camelNote/CameraPowerAdapter/CurrentSetup.JPG

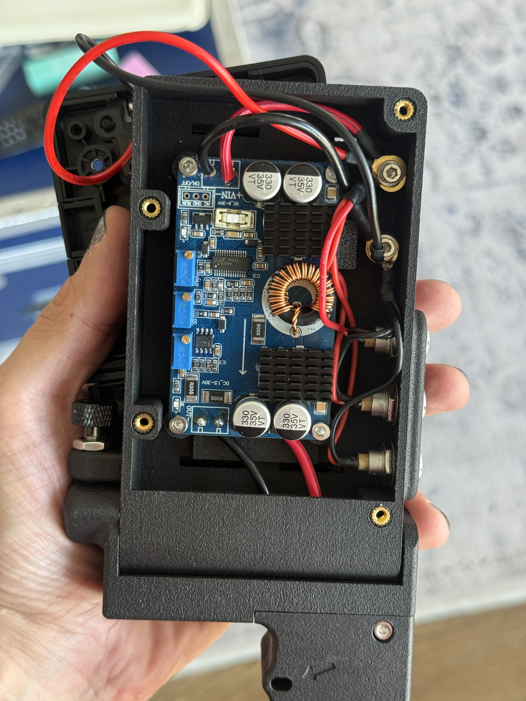
CurrentSetup.JPG
