camelNote/CameraPowerAdapter/DesignDocs/CameraPowerAdapter_DesignDocument.pdf

### Vintage Film Camera Equipment

# Dual-Input Priority-Switched

# Buck-Boost Power Adapter

## Custom Datasheet & Design Calculations

Document ID | CPA-DD-001
Revision | 0.1 — Draft / Template
Date | October 5, 2026
Author | [TODO: name]
Status | Work in progress — sections marked [TODO: ] are incomplete
Related spec | Specifications/SpecSheet.pdf
Supporting docs | BuckBoostTopology.md, ComponentSelection.md, SchematicBOM.md

This document defines the board as a standalone power module (custom datasheet) and records the calculations behind every selected value (design calculations).

Camera Power Adapter | Custom Datasheet & Design Calculations

### Contents

1 Introduction | 2
2 System Overview | 3
3 Custom Datasheet | 3
4 Design Calculations | 5
5 Verification & Test Plan | 8
6 Open Items & Risks | 9
A Bill of Materials | 9
B Equation Reference | 9
C Design Decisions Log | 9
D Open Items & Risk Register | 10
E Revision History | 10
F References | 10

### 1 Introduction

### 1.1 Purpose

This document serves two functions:
1. A custom datasheet for the assembled adapter — what the board does, its limits, and how to connect it.
2. A design calculation record — every value on the schematic is derived from an equation traceable to a manufacturer datasheet.

### 1.2 Scope

The adapter accepts two independent 11 V to 36 V DC inputs with fixed priority (Input 2 preferred), protects against reverse polarity and overcurrent, and delivers a jumper-selected 12 V or 24 V output rated 6 A to 8 A (burst duty cycle; see subsection 3.3).
[TODO: Confirm scope wording against the final schematic.]

### 1.3 Related documents

Document | Contents
Specifications/SpecSheet.pdf | Customer requirements / acceptance criteria
BuckBoostTopology.md | LT8390 stage build guide and audit log
ComponentSelection.md | Value-by-value selection rationale
SchematicBOM.md | Current bill of materials and placement status
Datasheets/ | Manufacturer datasheets (local copies)

Table 1: Reference documents.

### 1.4 Acronyms

Term | Meaning
UVLO | Under-voltage lockout
CC | Constant-current (limit)
HS / LS | High-side / low-side MOSFET switch
PGOOD Power-good output of the LT8390 (active low) NTC Negative temperature coefficient thermistor

Table 2: Acronyms and definitions.

### 2 System Overview

### 2.1 Block diagram

Figure placeholder

Input 1 → [fuse, reverse-pol.] Input 2 → [fuse, reverse-pol.] }︃
Priority mux (LTC4417) → LT8390 buck-boost

→ 12 V/24 V output
Export a block diagram from KiCad or draw with TikZ and \includegraphics here.

Figure 1: System block diagram. [TODO: replace placeholder.]

### 2.2 Operating modes

Mode | Behaviour
Input priority | Input 2 powers the board whenever it is valid; automatic fallback to Input 1.
Buck region | VIN > VOUT — buck leg switches.
Boost region | VIN < VOUT — boost leg switches.
Overlap band | VIN ≈ VOUT — both legs switch (worst thermal corner).
Output select | Jumper fitted = 12 V; jumper removed = 24 V.
Over-temp fault Latch pulls EN/UVLO low until input power is cycled.

Table 3: Operating modes.

### 3 Custom Datasheet

### 3.1 Description

Dual-input, priority-selected, non-isolated synchronous buck-boost DC/DC adapter for vintage film camera equipment. Intended for low-duty-cycle loads (short bursts) inside a small enclosure — the enclosure floor acts as the heat sink through a bottom-side thermal pad.

### 3.2 Absolute maximum ratings

Parameter | Conditions / note | Max
Input voltage, either input | Continuous; reverse-polarity block extends to
| −42 V | 36 V
Output current | Burst rating | 8 A
Output current | Continuous duty (thermal-limited) | [TODO: 2 A?]
Operating ambient temperature [TODO: state enclosure assumption] | [TODO: ]
Storage temperature | | [TODO: ]

Table 4: Absolute maximum ratings. Stresses beyond these may damage the board.

### 3.3 Recommended operating conditions

Parameter | Conditions / note | Value
Input 1 voltage Valid operating window (UVLO ≈ 11 V) | 11 V to 36 V
Input 2 voltage Valid operating window (UVLO ≈ 11 V) | 11 V to 36 V
Output voltage | Jumper selection | 12 V or 24 V
Output current Real duty cycle (per spec) | 2 A to 4 A typical
Output current Short-burst rating | 6 A to 8 A
Ambient | Inside camera enclosure | [TODO: ]

Table 5: Recommended operating conditions.

### 3.4 Electrical characteristics

[TODO: fill min/typ/max columns once the first board is measured; values below are design targets, not tested limits.]

Parameter | Conditions / note | Target

Inputs
Input priority | Fixed, not voltage-based | Input 2 > Input 1
UVLO per channel | Set by priority controller; below mux floor | 11 V ± [TODO: ]
Reverse polarity | Both inputs independently | −42 V capable
Fuse per input line | Sized from worst-case input current | [TODO: rating]
Input current (worst case) POUT /(η · VIN,min) | [TODO: value in A]

Output
Output voltage accuracy | LT8390 FB accuracy | ±1.5 %
Output current limit | R11 = 12 m Ω (provisional) | 8.33 A
Output ripple | Measured at rated burst load | [TODO: mVpp]

Protection & indicators
Over-temperature trip | NTC/TL431 latch (provisional) | ≈85 ◦C ± 8

◦C
Fault recovery | Latch-off; requires input power cycle | —
Indicators | Green = output OK, red = fault, red = over-
temp

see Table 9

Table 6: Electrical characteristics (design targets).

### 3.5 Connector pinout

Designator | Signal | Note
IN1 | Input 1 positive | M3 solder-on threaded standoff
IN1 | Input 1 return | M3 solder-on threaded standoff
IN2 | Input 2 positive | M3 solder-on threaded standoff
IN2 | Input 2 return | M3 solder-on threaded standoff
OUT | Output positive (V+) | M3 solder-on threaded standoff
OUT | Output return (GND) M3 solder-on threaded standoff

Table 7: I/O connections. [TODO: confirm silkscreen labels once the layout is done.]

### 3.6 Mechanical & environmental

Parameter | Value / requirement
PCB outline | 45 mm × 75 mm max
Mounting holes | 4 × 3 mm dia., 70 mm × 40 mm pattern
Bottom thermal pad 45 mm × 40 mm, contact with enclosure floor
Assembled height | < 13.5 mm target; 18 mm fallback ceiling
Indicators | Bottom side, output end

Table 8: Mechanical requirements.

### 3.7 Indicator logic

Green (power) Red (fault) Red (over-temp)

ON | OFF | OFF
OFF | ON | OFF
OFF | OFF | ON

Table 9: Indicator truth table. [TODO: add state column once LED wiring is final.]

### 3.8 Typical application

Place the annotated top-level schematic or KiCad plot here.

Figure 2: Typical application circuit. [TODO: replace placeholder.]

### 4 Design Calculations

Note — All equations are from the LT8390 datasheet, Rev. F (Applications Informa-tion, pp. 17–25) unless stated otherwise. Values tagged (provisional) are carried over from BuckBoostTopology.md and must be re-verified once the schematic is frozen.

### 4.1 Input stage — priority mux and protection

- Priority controller: LTC4417 (or equivalent) — fixed pin-assigned priority, Input 2 wired to the highest-priority pin.
- Per-channel UVLO: program the controller’s undervoltage threshold to 11 V. [TODO: insert resistor calculation from the LTC4417 datasheet: VUV threshold and hysteresis formulas, show Rtop, Rbot.]
- Fuse sizing (each input line, ahead of the mux):

IF USE ≥

POUT

η · VIN,min

kmargin | (1)

with the worst-case input current evaluated at VIN,min = 11 V and the burst power (24 V × 8 A = 192W). Margin factor kmargin = [TODO: 1.5–2, to be confirmed]. [TODO: finalize after the efficiency estimate (subsection 4.9)].

### 4.2 Buck-boost power stage

### 4.2.1 Switching frequency

R12 = 226 kΩ (1 %) selects fSW = 200 kHz (datasheet Table 1). Spread spectrum ON (±15 % modulation) for lower EMI. Rationale: thermal/size compromise; see Appendix C.

### 4.2.2 Inductor ripple current

∆IL(BUCK) =

VOUT (VIN(MAX) − VOUT )

fSW L VIN(MAX)

(2)

∆IL(BOOST) =

VIN(MIN)

(VOUT − VIN(MIN)

)

fSW L VOUT

(3)

Worked worst case (11 V in, 24 V out, L = 10 µH, fSW = 200 kHz):

∆IL(BOOST) =

11 V (24 V − 11 V)
200 kHz · 10 µH · 24 V
≈ 2.98 A | (4)

### 4.2.3 Inductor selection

LBUCK >

VOUT (VIN(MAX) − VOUT )

fSW IOUT ∆IL% VIN(MAX)

(5)

LBOOST >

V

2
IN(MIN)

(VOUT − VIN(MIN)

)

fSW IOUT ∆IL% V

2
OUT

(6)

slope-comp. stability: L > 10 VOUT RSENSE

fSW

≈ 2.4 µH | (7)

Chosen: L1 = 10 µH, ≥18 A saturation, ferrite, low DCR. Height-budget tradeoff: the 11 V→24 V, 8 A corner peaks at ≈19 A — accepted, see risk log (Appendix D).

### 4.2.4 Inductor current sense and peak limit

RSENSE(BUCK) =

2 · 50 mV

2 IOUT + ∆IL(BUCK)

(8)

RSENSE(BOOST) =

2 · 50 mV · VIN(MIN)

2 IOUT VOUT + ∆IL(BOOST) VIN(MIN)

(9)

Worst corner (11 V in, 24 V out, 8 A): RSENSE(BOOST) ≈ 2.64 m Ω. Chosen R5 = 2 m Ω ⇒ 24 % margin (datasheet requires final value 20–30 % below calculated). Peak limit: IP EAK = 50 mV/R5 = 25 A.

### 4.2.5 Output CC limit and monitor

With CTRL tied to VREF (≥ 1.35 V), the ISP/ISN threshold is the full 100 mV scale:

ILIM =

100 mV

R11

=

100 mV
12 m Ω = 8.33 A | (10)

Monitor output: VISMON = 10 V(ISP −ISN)+0.25 V. [TODO: transcription re-checked against the LT8390 datasheet p. 22.]

### 4.2.6 Capacitors

- Input: RMS ripple current in the buck region IIN,RMS ≈ IOUT √︁
D(1 − D), D = VOUT /VIN ;
worst case D = 0.5 gives IOUT /2 ≈ 4 A at the 8 A burst rating — shared by C11–C14 (4 × 10 µF, 50 V X7R/X7S, 1210). Plus C8 = 1 µF at the VIN pin.
- Output: C19–C22 (4 × 10 µF, 50 V) + C23 (180 µF polymer); C24 = 1 µF at the VOUT pin.
- Bootstrap: C10, C18 = 100 nF X7R (≥100× top-FET gate charge; datasheet range 0.1 µF to 0.47 µF).
- INTVCC: C15 = 4.7 µF plus a second 1 µF right at the pin (datasheet layout recommenda-tion).

### 4.2.7 MOSFET selection

Q3–Q6 = NCEP40T11G (logic-level; gate drive is the 5 V INTVCC rail). RDS(ON) ≈ 3.3 m Ω typ. at VGS = 4.5 V. 40 V BVDSS on a 36 V rail leaves ≈11 % ringing headroom — bench-verify, snubber if needed.

### 4.3 Feedback divider and output voltage select

VOUT = 1.00 V ×

Rtop + Rbot

Rbot

, | Rbot = R17 = 10.0 kΩ | (11)
12 V : Rtop = R15 = 110 kΩ | (12)
24 V : Rtop = R15 + R16 = 230 kΩ | (13)

J1 shunts R16: fitted = 12 V, removed = 24 V; a missing jumper defaults to 12 V (fails low, no runaway).

### 4.4 Enable / UVLO

VIN(turn-on) = 1.233 V ·

R8 + R9
R9

+ 2.5 µA · R8

VIN(turn-of f) = 1.220 V ·

R8 + R9
R9

(14)

With R8 = 365 kΩ, R9 = 56.2 kΩ: ≈10.2 V on, ≈9.1 V off — deliberately below the LTC4417’s 11 V floor so the mux arbitrates first.

### 4.5 Soft-start and compensation

tSS =

1 V · C9
12.5 µA

=

1 V · 100 nF
12.5 µA
≈ 8 ms | (15)

R10 = 499 kΩ (SS→VREF) selects latch-off on fault. Compensation R13 = 15 kΩ + C25 = 15 nF; bench-tune with load steps at both outputs. Constraint: C9 ≥ 5–10 × C25 (ratio here: 6.7×, OK).

### 4.6 Over-temperature latch

Trip point set by the NTC divider against the TL431’s 2.495 V reference, fed from a 5.1 V zener rail so the trip point barely moves with battery voltage:

RNT C(trip) = R21 (︃

VZ
2.495

− 1

)︃
= 1.33k

(︃

5.1
2.495

− 1

)︃
≈ 1.39 kΩ | (16)

⇒ trip ≈85 ◦C nominal, ±8

◦C realistic (zener tolerance, TL431 grade, NTC B-tolerance). TH1 (10 k NTC) must be mounted on the hot copper, not in free air. Latch resets only when input power is cycled.

### 4.7 Indicator resistors

Continuous worst case is 36 V input; sizes chosen so no resistor exceeds ≈50 % of its package rating:

Ref | Value | Dissipation (worst case) Package
R18 (green) 4.7 kΩ | ≈0.10W | 1206
R19 (red) | 6.8 kΩ | ≈0.17W | 1206 min., 2010 preferred
R29 (red) | 6.8 kΩ | ≈0.17W | 1206 min., 2010 preferred

Table 10: LED series resistors. [TODO: re-check currents against final LED VF bins.]

### 4.8 Thermal analysis

- INTVCC self-heating (≈1.6W inside the IC at 36 V, 200 kHz, four ≈50 nC gates):
P = VIN · IINT V CC ≈ 36 · 45 mA ≈ 1.6W, | TJ = TA + P θJA | (17)

[TODO: verify θJA for the chosen layout and confirm TJ at max ambient; fallback options: 150 kHz, lower-Qg FETs.]
- Bottom thermal pad: 45 mm×40 mm exposed pad, vias from U1 exposed pad and the power MOSFETs; contact with the enclosure floor. [TODO: add measured case temperature once available.]
- Heatsinks: low-profile finned heatsinks on U1 and the switching MOSFETs where height allows.

### 4.9 Efficiency budget

[TODO: fill from bench measurement or a loss budget (conduction + switching + gate charge). One row per corner:]

Corner | Input | Output
Buck, 36 V → 12 V, 2 A | [TODO: %] [TODO: %]
Buck-boost corner, 12 V in, 12 V out [TODO: %] [TODO: %]
Boost, 11 V → 24 V, 2 A | [TODO: %] [TODO: %]

Table 11: Efficiency at nominal duty.

### 5 Verification & Test Plan

[TODO: expand into a full procedure once the first board is built.]

Test | Pass criterion
Input priority | Input 2 always selected when valid; clean fallback to Input 1
UVLO per channel Both channels disable below 11 V, restart above it
Reverse polarity | No damage / no output with either input reversed
Output voltage | 12 V and 24 V within ±1.5 % at nominal load
Output CC limit | Current limit at 8.33 A ± tolerance
Load transient | Stable at both outputs, no latch-off, acceptable deviation
Over-temp trip | Latch fires at target temperature; recovers only on power cycle
Thermal soak | TJ , case and enclosure-floor temperatures within limits at worst corner

Table 12: Verification test matrix.

### 6 Open Items & Risks

See the risk register in Appendix D.

### A Bill of Materials

[TODO: Keep in sync with SchematicBOM.md; summarize the main parts here.]

Ref | Part / value | Purpose | Status
U1 | LT8390 (TSSOP-28 EP) Buck-boost controller | placed
Q3–Q6 | NCEP40T11G | Power switches | placed
L1 | 10 µH, ≥18 A sat | Main inductor | placed
R5 | 2 m Ω | Inductor current sense | placed
R11 | 12 m Ω | Output current sense | placed
U3 + TH1 | TL431 + NTC | Over-temp comparator / sen-
| | sor | [TODO: verify]
Q7–Q11, D1–D4, J1 | [TODO: parts] | Latch, LEDs, output select | to add

Table 13: Principal components (excerpt).

### B Equation Reference

Full derivations live in section 4; this is a quick-reference index.

Quantity | Equation | | Source
Inductor ripple (buck) | VOUT (VIN(MAX) − VOUT )/(fLVIN(MAX)
| | ) | LT8390 p. 18
Inductor ripple (boost) VIN(MIN)

(VOUT − VIN(MIN)

| | )/(fLVOUT ) | LT8390 p. 18
Peak current limit | IP EAK = 50 mV/RSENSE | LT8390 p. 18
Output CC limit | ILIM = 100 mV/R11 (CTRL high) | LT8390 p. 22
Output voltage | VOUT = 1.00 · (Rtop + Rbot)/Rbot | LT8390 p. 21
UVLO | VIN = 1.233 (R8 + R9)/R9 + 2.5 µA R8 | LT8390 p. 21
Soft-start | tSS = 1 V · C9/12.5 µA | LT8390 p. 21
NTC trip resistance | RNT C = R21(VZ/2.495 − 1) | TL431 datasheet
NCV/[TODO:] | [TODO: ] | | [TODO: ]

Table 14: Equation quick reference.

### C Design Decisions Log

Decision | Date
LT8390 4-switch buck-boost: single inductor, input straddles both outputs, PGOOD + latch-off available. | 2026-09
200 kHz switching: thermal/size compromise; spread spectrum on. | 2026-09
10 µH/18 A-sat inductor: height budget; accepted 19 A corner peak. | 2026-09
Jumper presets instead of trim pot: no drift, no knob to bump, lower height. | 2026-09
Latch pulls EN/UVLO: assured full shutdown; resets only on power cycle. | 2026-09
Two red LEDs (fault vs. over-temp): distinguishable states, simpler than steered diode. | 2026-09
[TODO: append each new decision with rationale and date.]

Table 15: Design decision record.

### D Open Items & Risk Register

Item | Severity | Status
Analog support blocks (Q7–Q11, D1–D4, J1, TH1) not yet placed | high | open
No footprints assigned on any symbol | high | open
Fuse ratings not finalized | medium | open
INTVCC self-heating (≈1.6W) — TJ margin unverified | high | open
19 A corner peak vs. 18 A inductor saturation | medium | accepted
40 V FETs on 36 V rail — ringing headroom | medium | bench-check
Height budget: PCB + parts + heatsink under 13.5 mm | medium | open

Table 16: Open items carried from the current schematic audit.

### E Revision History

Rev | Date | Author | Change
0.1 | October 5, 2026 [TODO: name] Initial template created
[TODO: ] [TODO: ] | [TODO: ] | [TODO: ]

Table 17: Revision history.

### F References

[1] LT8390 datasheet, Rev. F — Datasheets/LTC8390.pdf
[2] LTC4417 datasheet — Datasheets/LTC4417.pdf
[3] NCEP40T11G datasheet — Datasheets/NCEP40T11G.pdf
[4] TL431 datasheet — [TODO: download to Datasheets/agentDownload/]
[5] Project specification — Specifications/SpecSheet.pdf
[6] [TODO: add any further references as they are used.]
