camelNote/CameraPowerAdapter/PageScreenshot.png

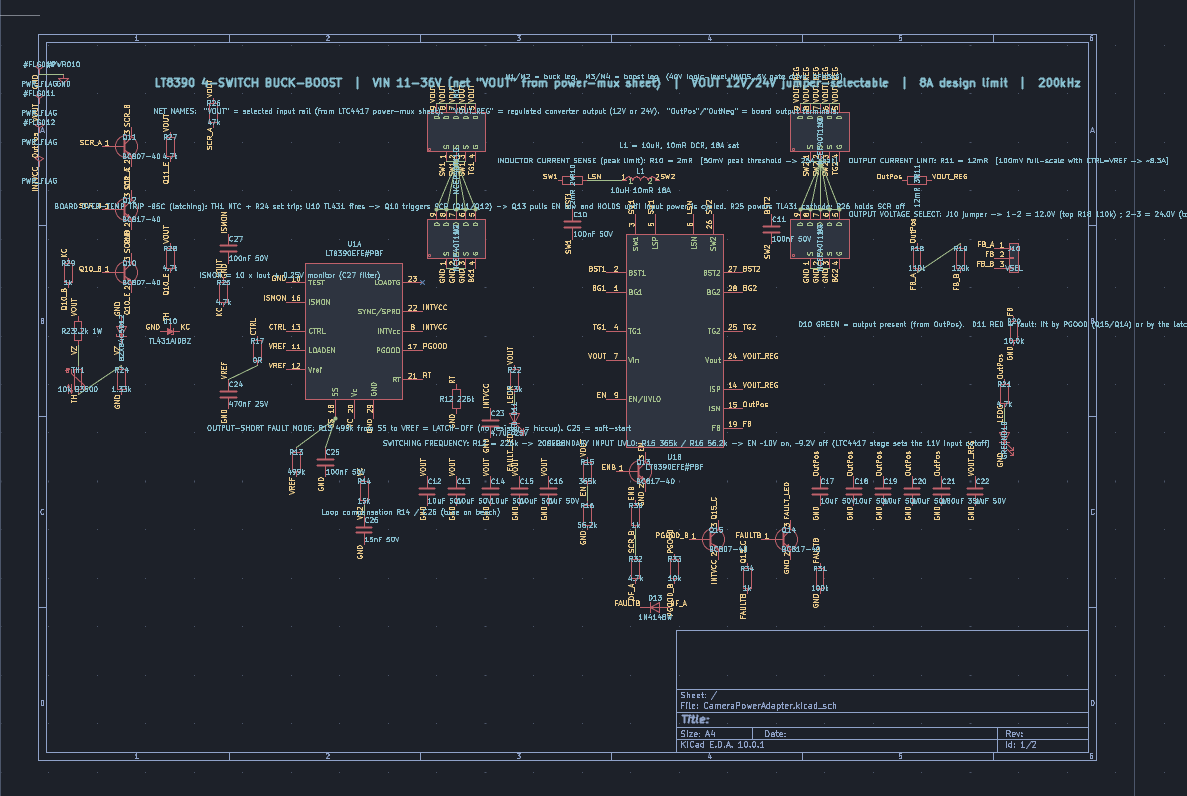
PageScreenshot.png
