camelNote/CameraPowerAdapter/CAD/EnclosureFitting/ProtoBoard_Ports.step

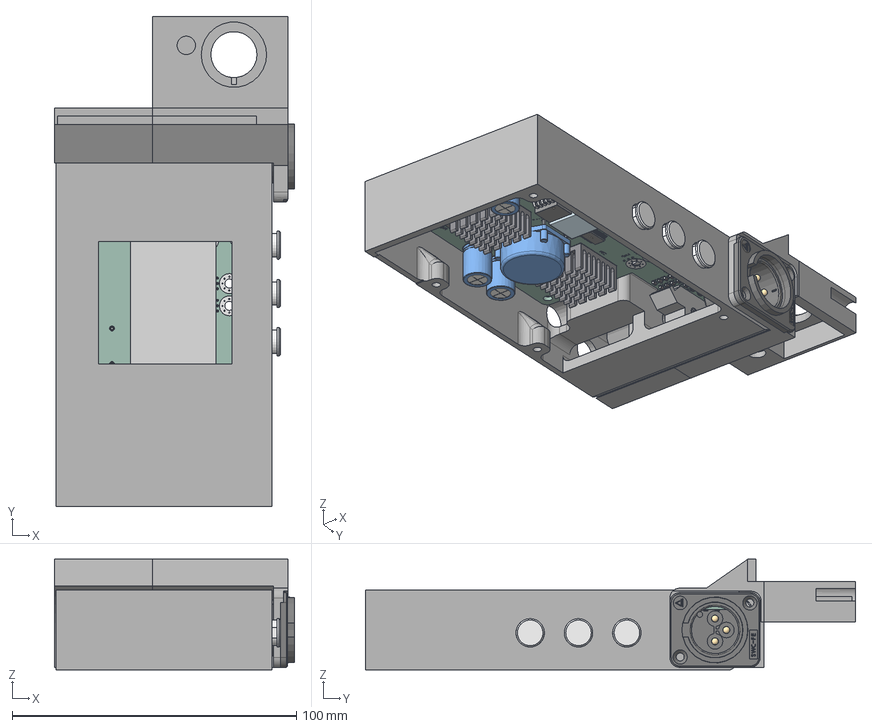
[picture p3: CAD file, 2026-10-28]
CAD/EnclosureFitting/ProtoBoard_Ports.step
84.4 x 172.5 x 38.9 mm
Upper
Lower (1)
Lower (2)
XLR
Lower
heatsink x 2
DFN-8_L5.1-W5.7-H1.0-P1.27 x 4
C_0603_1608Metric x 26
R_0603_1608Metric x 16
D_0805_2012Metric x 2
CameraPowerAdapter_PCB
C_Radial_D10.0mm_H12.5mm_P5.00mm x 3
D_SOD-523
Fuse_0805_2012Metric x 2
SOIC-8_3.9x4.9mm_P1.27mm x 2
R_0201_0603Metric
protoPCB 1.61.1 x 3
Choke_EPCOS_B82722A
TO-263-5-5P_L10.2-W8.7-H4.5-LS14.4-P1.70 x 2
SSOP-24_L8.7_W3.9-H1.7-LS6.0-P0.64 x 38
R_0805_2012Metric
TSSOP-28_L9.7-W4.4-H1.0-LS6.4-P0.65 x 42
CameraPowerAdapter_silkscreen x 275
CameraPowerAdapter_pad x 515
