camelNote/CameraPowerAdapter/CAD/SR Box/SR Box/SR3 Battery Box v2.2.step

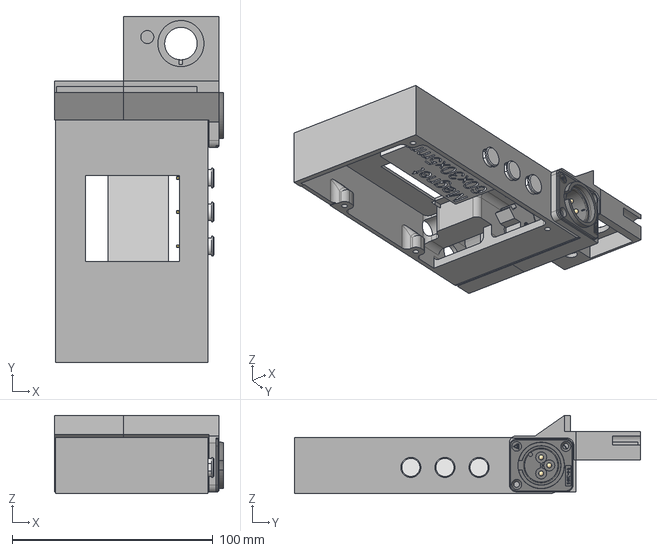
[picture p4: CAD file, 2026-10-28]
CAD/SR Box/SR Box/SR3 Battery Box v2.2.step
84.4 x 172.5 x 38.9 mm
