camelNote/CameraPowerAdapter/PCB/3dmodels/Heatsink_20x20x10_XSD271-294.step

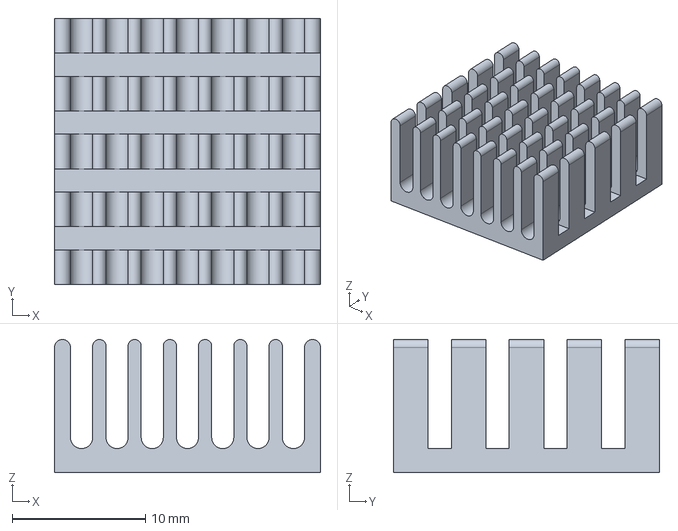
[picture p5: CAD file, 2026-10-28]
PCB/3dmodels/Heatsink_20x20x10_XSD271-294.step
20.0 x 20.0 x 10.0 mm
