camelNote/CameraPowerAdapter/PCB/PCB.step

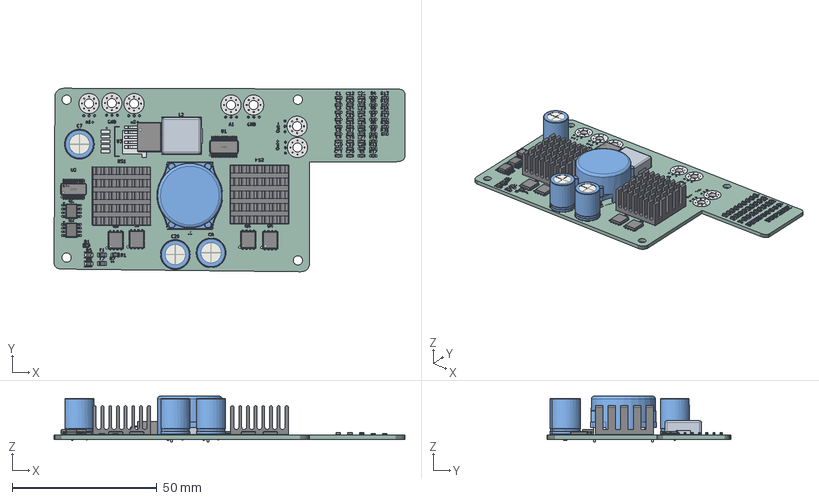
[picture p6: CAD file, 2026-10-28]
PCB/PCB.step
121.2 x 63.4 x 15.8 mm
R_0603_1608Metric x 16
C_0603_1608Metric x 26
TSSOP-28_L9.7-W4.4-H1.0-LS6.4-P0.65
D_SOD-523
TO-263-5-5P_L10.2-W8.7-H4.5-LS14.4-P1.70
R_0201_0603Metric
Fuse_0805_2012Metric x 2
DFN-8_L5.1-W5.7-H1.0-P1.27 x 4
SSOP-24_L8.7_W3.9-H1.7-LS6.0-P0.64
R_0805_2012Metric
D_0805_2012Metric x 2
SOIC-8_3.9x4.9mm_P1.27mm x 2
Choke_EPCOS_B82722A
C_Radial_D10.0mm_H12.5mm_P5.00mm x 3
heatsink x 2
PCB 1.61.1
CameraPowerAdapter_pad
CameraPowerAdapter_silkscreen
CameraPowerAdapter_PCB
