camelNote/CameraPowerAdapter/(list of files, cad)

Other CAD files:
PCB/protoPCB.step
CAD/SR Box/SR Box/SR3 Battery Box v2.2.stl
PCB/protoPCB.stl
