camelNote/CameraPowerAdapter/PCB/SchematicSeptember18_2026.pdf

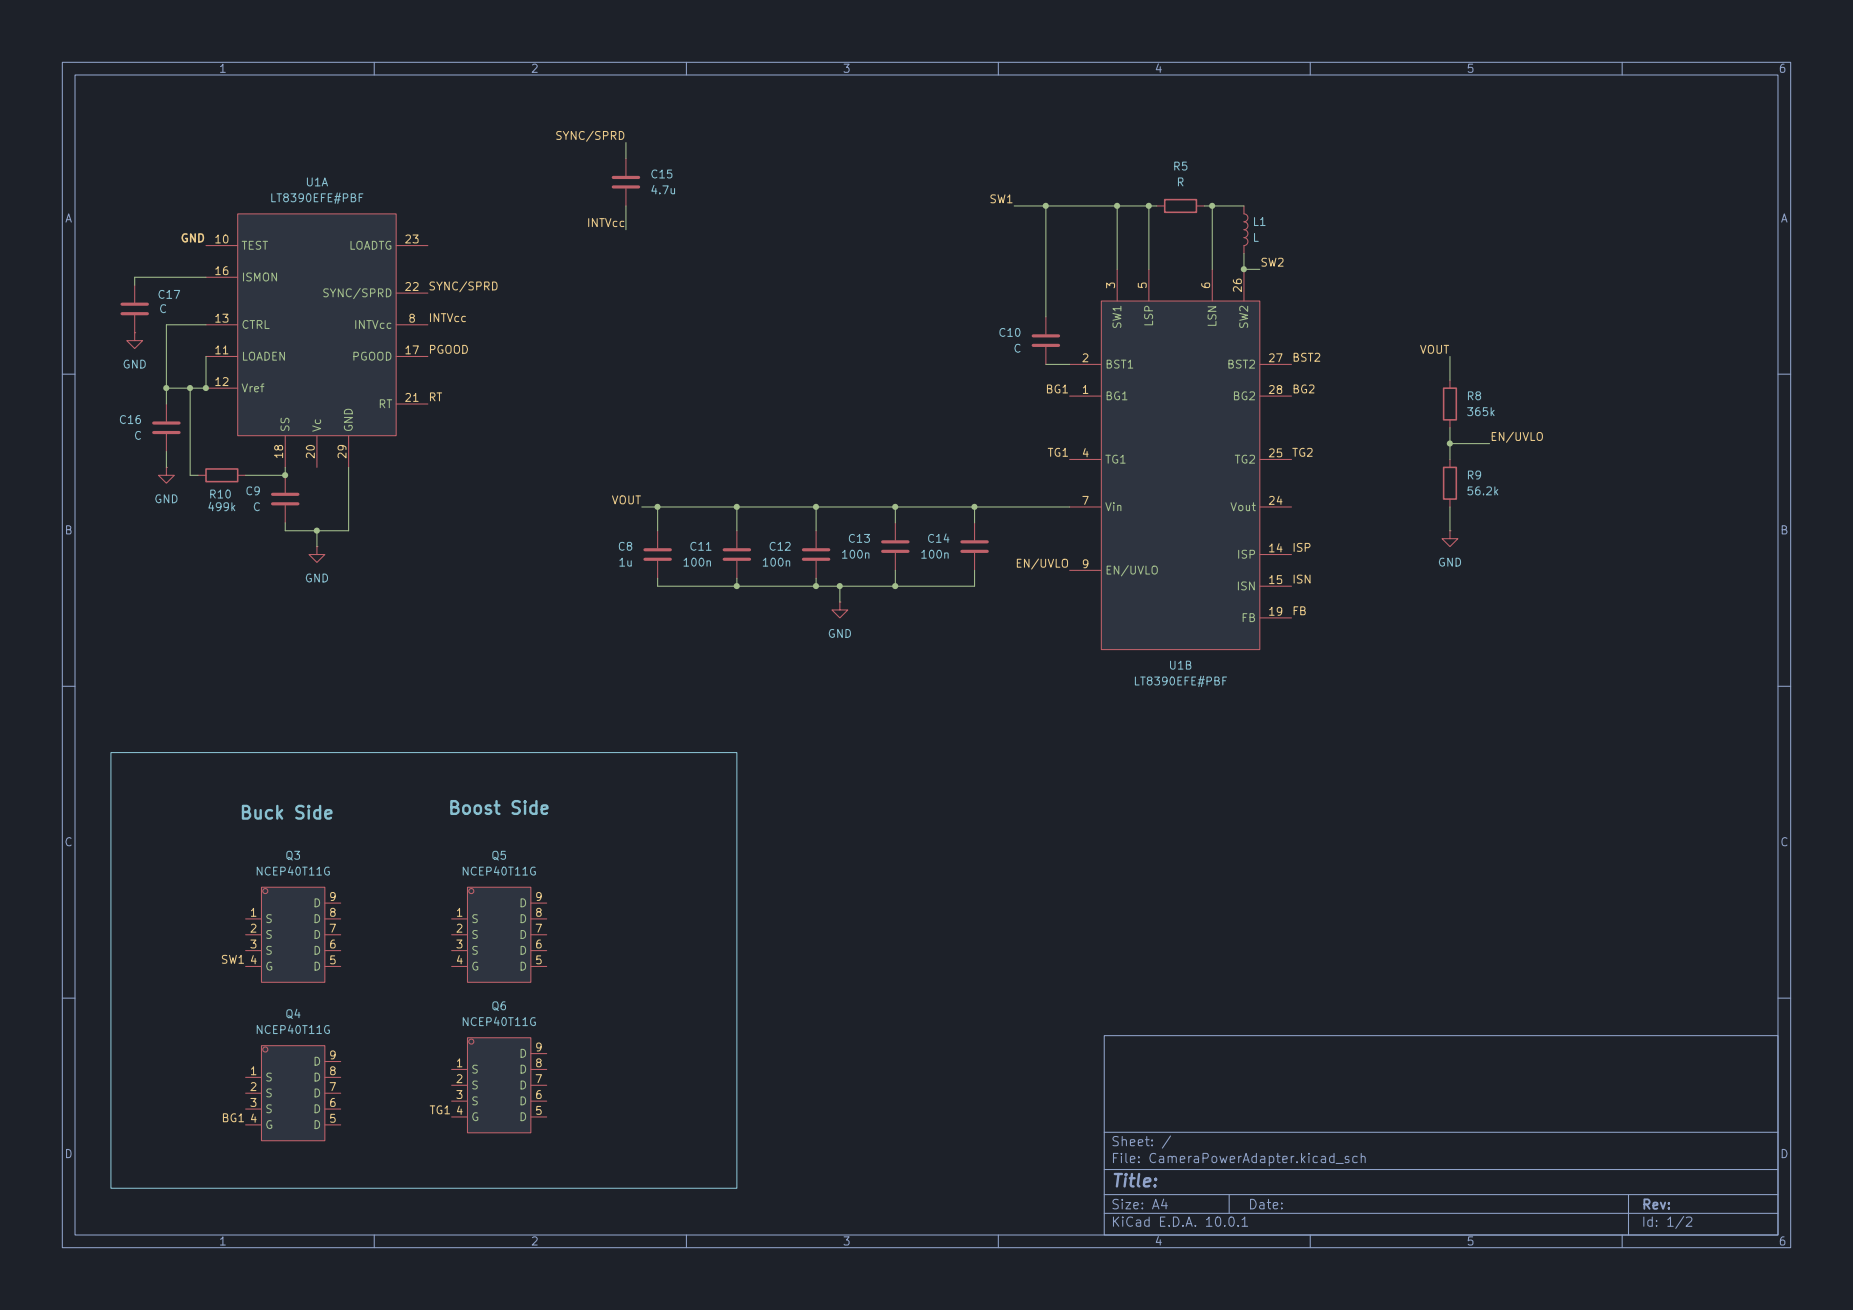
[picture p7: page 1]

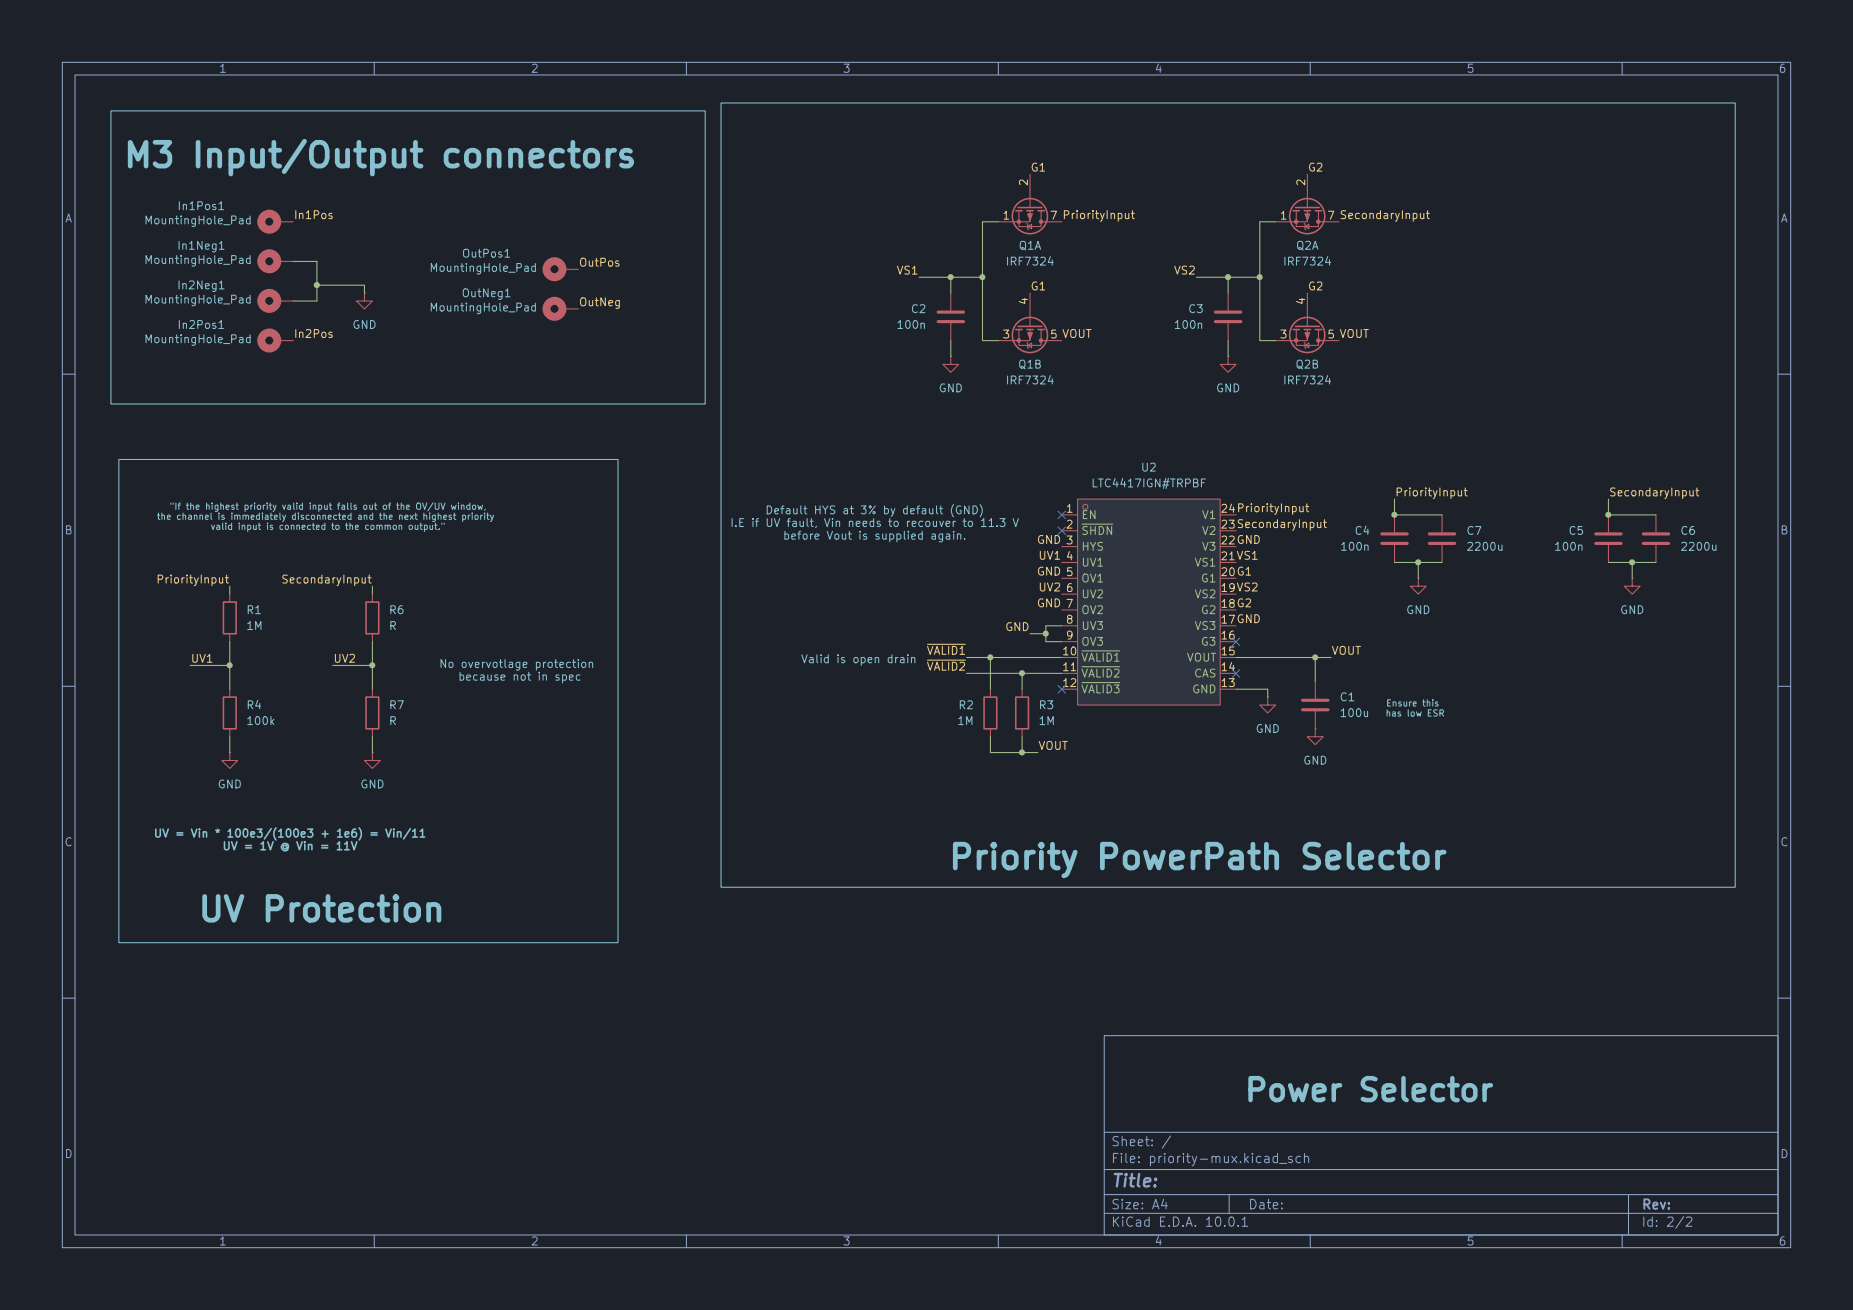
[picture p8: page 2]
