camelNote/CameraPowerAdapter/heatSink.pdf

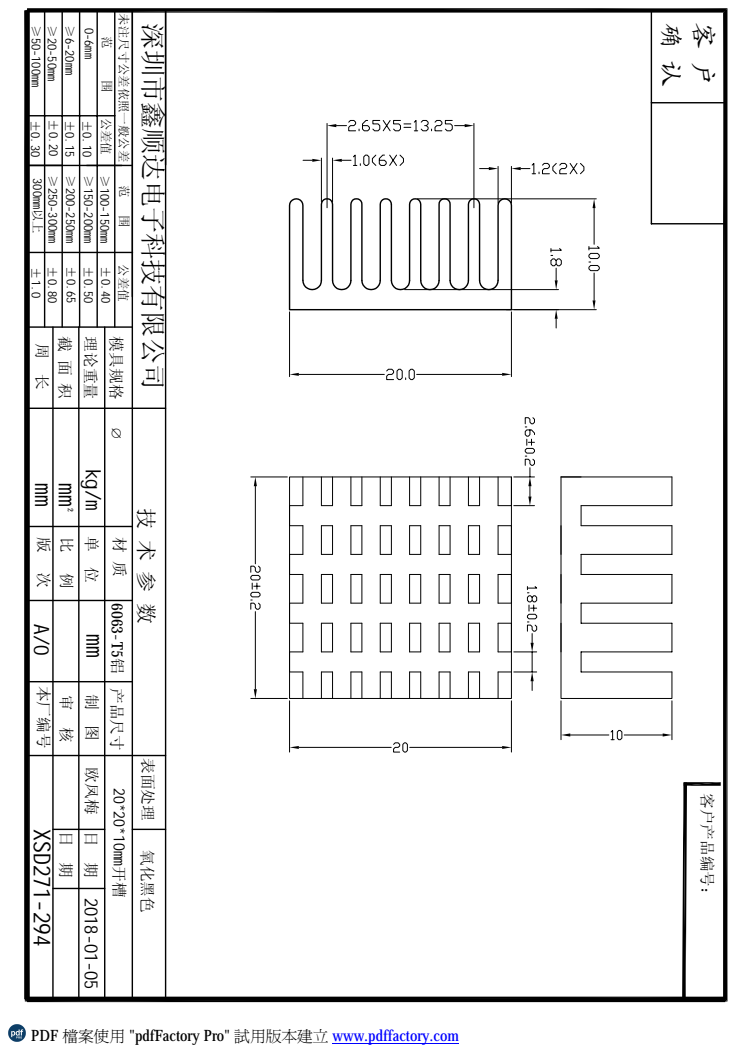
[picture p9: page 1]
6063-T5铝 模具规格; 本厂编号 周 长; 理论重量; XSD271-294; 产品尺寸; 表面处理; 客户产品编号：; 未注尺寸公差依照一般公差; 范 围 公差值; 300mm以上 ±1.0; kg/m 2018-01-05 欧凤梅; 20*20*10mm开槽; 氧化黑色 深圳市鑫顺达电子科技有限公司; com

PDF 檔案使用 "pdfFactory Pro" 試用版本建立 www.pdffactory.
