camelNote/CameraPowerAdapter/PCB/CameraPowerAdapter.kicad_pcb

## KiCad design PCB/CameraPowerAdapter.kicad_pcb (2026-10-28)

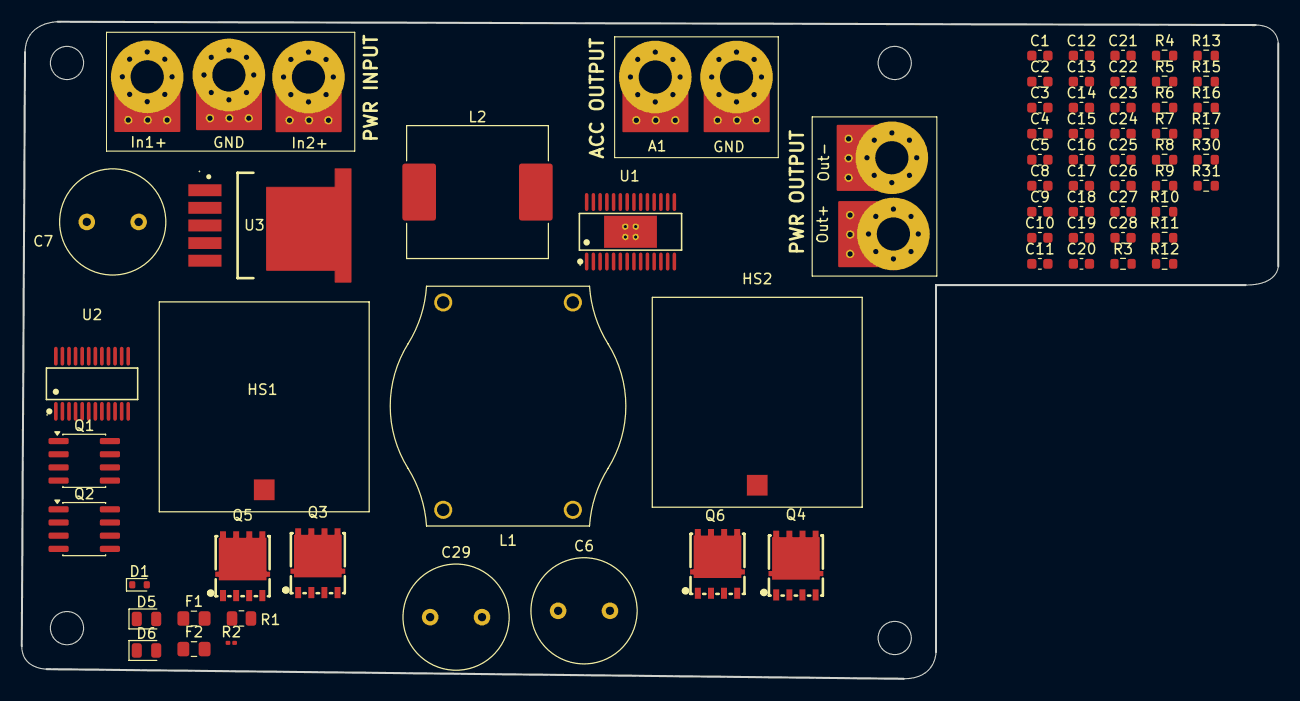
[picture p10: board CameraPowerAdapter.kicad_pcb from above]

Board: 2 copper layers, 121.2 x 63.4 mm, 76 parts (0 on the bottom side), 38 nets, no tracks yet.

Parts:
A1: MountingHole_Pad; MG_ThermalTab_M3
C1: 100u; C_0603_1608Metric
C2, C3, C4, C5, C9, C10, C17, C18, C26, C27: 100n; C_0603_1608Metric
C6, C7: 2200u; C_Radial_D10.0mm_H12.5mm_P5.00mm
C8, C24, C28: 1u; C_0603_1608Metric
C11, C12, C13, C14, C19, C20, C21, C22: 10u; C_0603_1608Metric
C15: 4.7u; C_0603_1608Metric
C16: 470n; C_0603_1608Metric
C23: 180u; C_0603_1608Metric
C25: 15n; C_0603_1608Metric
C29: 220u; C_Radial_D10.0mm_H12.5mm_P5.00mm
D1: 1N914; D_SOD-523
D5, D6: Schottky; D_0805_2012Metric
F1, F2: Fuse; Fuse_0805_2012Metric_Pad1.15x1.40mm_HandSolder
GND: MountingHole_Pad; MG_ThermalTab_M3
GND#2: MountingHole_Pad; MG_ThermalTab_M3
H1, H2, H3, H4: MountingHole; MountingHole_3.2mm_M3
HS1, HS2: Heatsink_Pad; Heatsink_20x20x10_XSD271-294
In1+, In2+: MountingHole_Pad; MG_ThermalTab_M3
L1: 10uH; Choke_EPCOS_B82722A
L2: L; L_Sunlord_MWSA1205S-470
Out+: MountingHole_Pad; MG_ThermalTab_M3
Out-: MountingHole_Pad; MG_ThermalTab_M3
Q1, Q2: IRF7324; SOIC-8_3.9x4.9mm_P1.27mm
Q3, Q4, Q5, Q6: NCEP40T11G; DFN-8_L5.1-W5.7-P1.27-LS6.1-BL
R1: 1M; R_0805_2012Metric
R2: 1M; R_0201_0603Metric
R3, R6: 1M; R_0603_1608Metric
R4, R7: 100k; R_0603_1608Metric
R5: 2m; R_0603_1608Metric
R8: 365k; R_0603_1608Metric
R9: 56.2k; R_0603_1608Metric
R10: 499k; R_0603_1608Metric
R11: 12m; R_0603_1608Metric
R12: 226k; R_0603_1608Metric
R13: 15k; R_0603_1608Metric
R15: 110k; R_0603_1608Metric
R16: 120k; R_0603_1608Metric
R17, R30: 10k; R_0603_1608Metric
R31: 1k; R_0603_1608Metric
U1: LT8390EFE#PBF; TSSOP-28_L9.7-W4.4-P0.65-LS6.4-BL-EP
U2: LTC4417IGN#TRPBF; SSOP-24_L8.8-W4.0-P0.64-LS6.2-BL
U3: LM2596SX-5.0/NOPB; TO-263-5_L10.2-W8.9-P1.70-TL

Connections:
/AccessoryBus: A1.1 (1_1), C29.1, L2.2, U3.4 (FB)
/BG1: Q4.4 (G), U1.1 (BG1)
/BG2: Q5.4 (G), U1.28 (BG2)
/BST2: C18.2, U1.27 (BST2)
/EN/UVLO: R8.2, R9.1, U1.9 (EN/UVLO)
/FB: R16.2, R17.1, U1.19 (FB)
/G1: Q1.2 (G1), Q1.4 (G2), U2.20 (G1)
/G2: Q2.2 (G1), Q2.4 (G2), U2.18 (G2)
/INTVCC: C15.1, C28.1, R30.2, U1.8 (INTVcc), U1.22 (SYNC/SPRD)
/In1Pos: F2.1, In1+.1 (1_1)
/In2Pos: F1.1, In2+.1 (1_1)
/LSN: C27.2, L1.1, R5.2, U1.6 (LSN)
/OutPos: C19.1, C20.1, C21.1, C22.1, C23.1, C26.2, Out+.1 (1_1), R11.2, R15.1, U1.15 (ISN)
/PGOOD: R30.1, R31.1, U1.17 (PGOOD)
/PriorityInput: C4.1, C7.1, F1.2, Q1.7 (D1), Q1.8 (D1), R1.1, U2.24 (V1)
/SW1: C10.1, C27.1, D5.1 (K), HS2.1, Q4.5 (D), Q4.6 (D), Q4.7 (D), Q4.8 (D), Q4.9 (D), Q6.1 (S), Q6.2 (S), Q6.3 (S), R5.1, U1.3 (SW1), U1.5 (LSP)
/SW2: C18.1, D6.2 (A), HS1.1, L1.2, Q3.1 (S), Q3.2 (S), Q3.3 (S), Q5.5 (D), Q5.6 (D), Q5.7 (D), Q5.8 (D), Q5.9 (D), U1.26 (SW2)
/SecondaryInput: C5.1, C6.1, F2.2, Q2.7 (D1), Q2.8 (D1), R6.1, U2.23 (V2)
/TG1: Q6.4 (G), U1.4 (TG1)
/TG2: Q3.4 (G), U1.25 (TG2)
/UV1: R1.2, R4.1, U2.4 (UV1)
/UV2: R6.2, R7.1, U2.6 (UV2)
/VC: R13.1, U1.20 (Vc)
/VC_RC: C25.1, R13.2
/VOUT_REG: C24.1, C26.1, D6.1 (K), Q3.5 (D), Q3.6 (D), Q3.7 (D), Q3.8 (D), Q3.9 (D), R11.1, U1.14 (ISP), U1.24 (Vout)
/VS1: C2.1, Q1.1 (S1), Q1.3 (S2), U2.21 (VS1)
/VS2: C3.1, Q2.1 (S1), Q2.3 (S2), U2.19 (VS2)
/Vmux: C1.1, C8.1, C11.1, C12.1, C13.1, C14.1, Q1.5 (D2), Q1.6 (D2), Q2.5 (D2), Q2.6 (D2), Q6.5 (D), Q6.6 (D), Q6.7 (D), Q6.8 (D), Q6.9 (D), R2.2, R3.2, R8.1, U1.7 (Vin), U2.15 (VOUT), U3.1 (VIN)
/~VALID1: R2.1, U2.10 (~VALID1), U3.5 (~ON/OFF)
/~VALID2: R3.1, U2.11 (~VALID2)
GND: C1.2, C2.2, C3.2, C4.2, C5.2, C6.2, C7.2, C8.2, C9.2, C11.2, C12.2, C13.2, C14.2, C15.2, C16.2, C17.2, C19.2, C20.2, C21.2, C22.2, C23.2, C24.2, C25.2, C28.2, C29.2, D1.2 (A), D5.2 (A), GND.1 (1_1), GND#2.1 (1_1), Q4.1 (S), Q4.2 (S), Q4.3 (S), Q5.1 (S), Q5.2 (S), Q5.3 (S), R4.2, R7.2, R9.2, R12.2, R17.2, U1.10 (TEST), U1.29 (GND), U2.3 (HYS), U2.5 (OV1), U2.7 (OV2), U2.8 (UV3), U2.9 (OV3), U2.13 (GND), U2.17 (VS3), U2.22 (V3), U3.3 (GND), U3.6 (GND)
unnamed: D1.1 (K), L2.1, U3.2 (OUTPUT)
unnamed: R15.2, R16.1
unnamed: C16.1, R10.2, U1.11 (LOADEN), U1.12 (Vref), U1.13 (CTRL)
unnamed: C17.1, U1.16 (ISMON)
unnamed: R12.1, U1.21 (RT)
unnamed: C9.1, R10.1, U1.18 (SS)
unnamed: C10.2, U1.2 (BST1)
