camelNote/CameraPowerAdapter/(commit log)

2026-09-15 init commit
    [CameraPowerAdapter.kicad_pcb, CameraPowerAdapter.kicad_sch, priority-mux.kicad_sch]
2026-09-17 Added circuitry for power mux
    [CameraPowerAdapter.kicad_sch, priority-mux.kicad_sch]
2026-09-17 Minor changes to schematic
    [priority-mux.kicad_sch]
2026-09-18 Updated Schematic
    [CameraPowerAdapter.kicad_sch, priority-mux.kicad_sch]
2026-09-18 Added pdf for current schematic
2026-09-18 Changed schematic print color
2026-09-20 Updated topology files to be more readable & BuckBoost schematic updated
2026-09-20 Added schematic changes
2026-09-20 Cleaned up schematic
2026-10-28 Updated schematic and created 3D assembly to check mechanical clearances and review with Thomas.
    To-do, clarify where the input and output ports should be.
